Bluescreen-CO/Projet-PPS-2/README.md

# Projet-PPS-2
Projet PPS 2 - Capteur de Gaz
