Bluescreen-CO/Projet-PPS-2/Diagramme Fonctionel/Diagramme_Schématique_VersionFinale.png

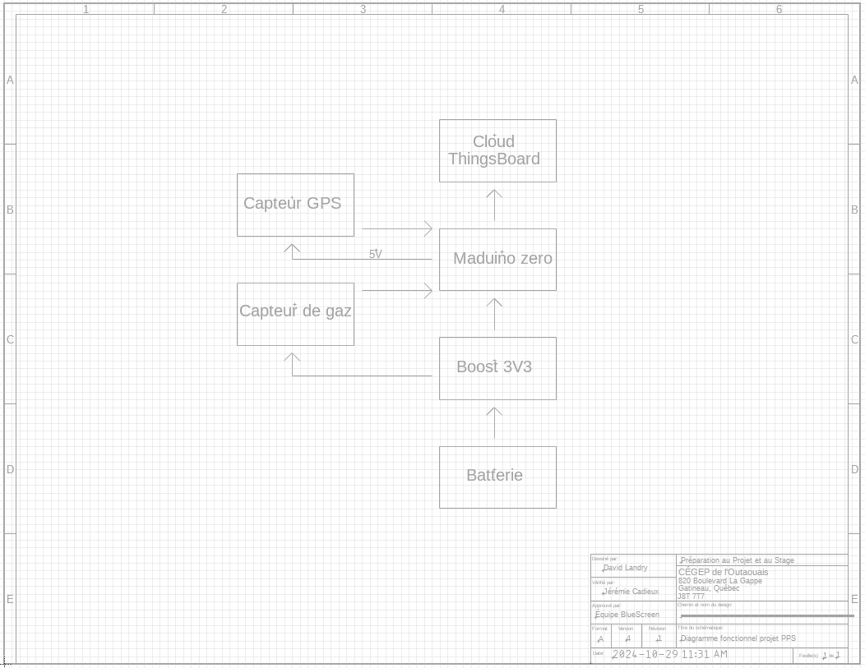
Diagramme Fonctionel/Diagramme_Schématique_VersionFinale.png
