Bluescreen-CO/Projet-PPS-2/Diagramme_Gants/Echeancier3.png

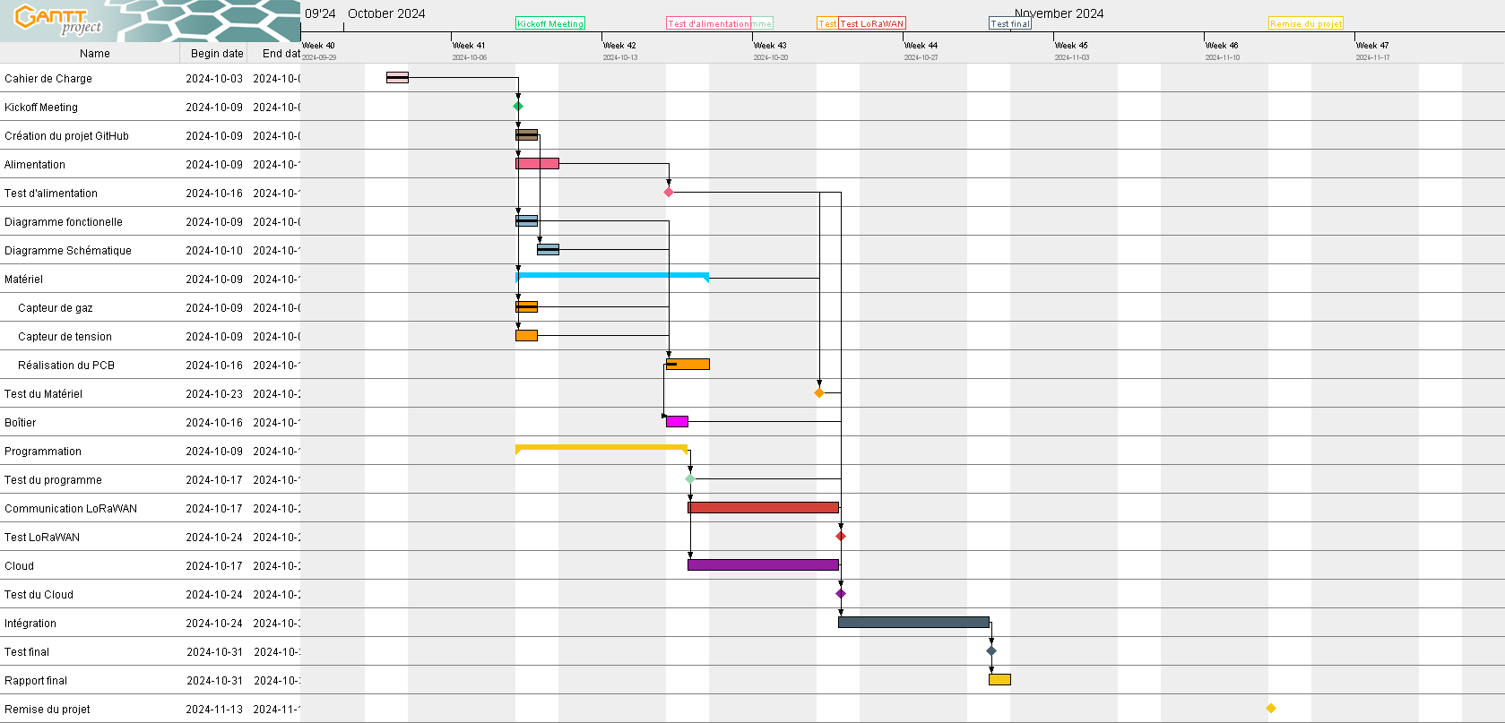
Diagramme_Gants/Echeancier3.png
