Bluescreen-CO/Projet-PPS-2/Diagramme_Gants/Plannification_1.png

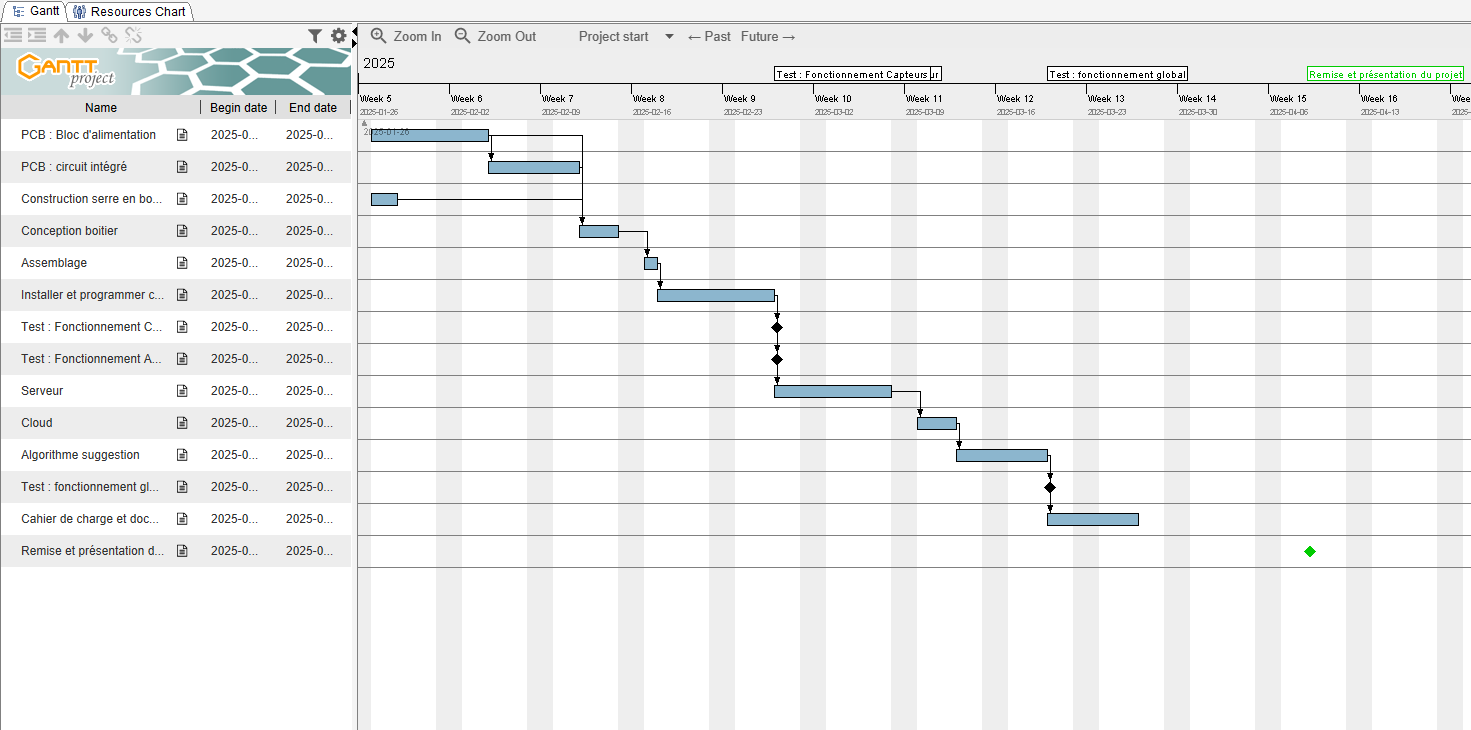
Diagramme_Gants/Plannification_1.png
