Bluescreen-CO/Projet-PPS-2/ProjetPPS_VSCODE_V1/PPS_Equipe_BlueScreen/Photo_Fonctionement/GPS_ArduinoUNO.png

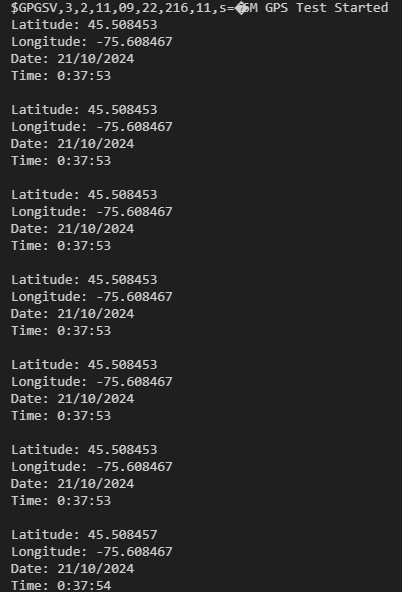
ProjetPPS_VSCODE_V1/PPS_Equipe_BlueScreen/Photo_Fonctionement/GPS_ArduinoUNO.png
