Bluescreen-CO/Projet-PPS-2/Modele_3D/Boitier_3D_Top_v4.stl

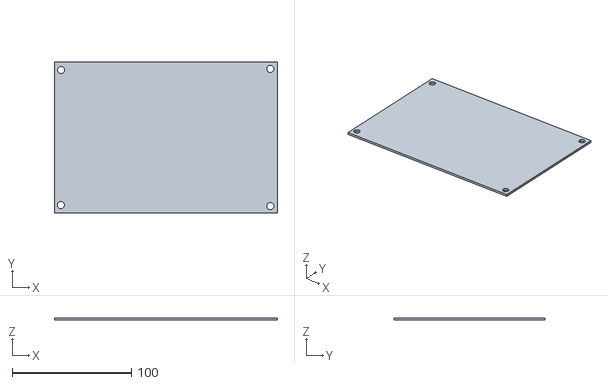
[picture p45: CAD file, 2024-11-06]
Modele_3D/Boitier_3D_Top_v4.stl
187.0 x 127.0 x 2.00
