Bluescreen-CO/Projet-PPS-2/Modele_3D/Modele_3D_v2/boitier3D_top_v8.stl

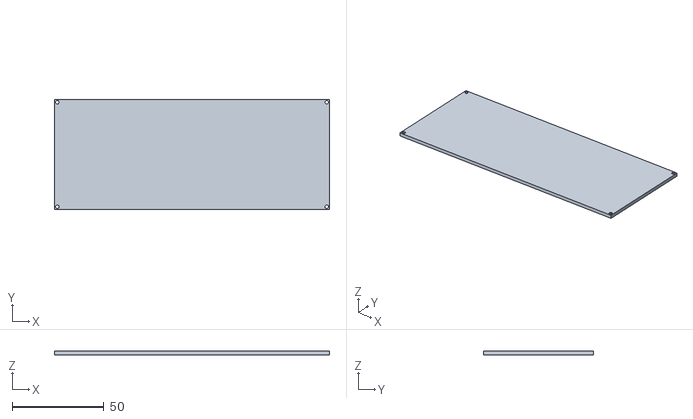
[picture p46: CAD file, 2024-11-14]
Modele_3D/Modele_3D_v2/boitier3D_top_v8.stl
150.0 x 60.0 x 2.00
