Bluescreen-CO/Projet-PPS-2/(list of files, cad)

Other CAD files:
Diagramme Schématique et Matriciel pour la carte principale/Diagramme Matriciel.f3z
Diagramme Schématique et Matriciel pour la carte principale/Diagramme Schématique.f3z
Diagramme Schématique et Matriciel Boost 5V/Diagramme Schématique Boost 5V.f3z
Diagramme Schématique et Matriciel Boost 5V/Schématique Matriciel Boost 5V.f3z
