Bluescreen-CO/Projet-PPS-2/Tableau_problemes_solutions/Liste des problèmes, solutions et choix.xlsx

Sheet: Feuille 1
Dans cette colomne préciser le nom de votre équipe | Dans cette colomne préciser le titre de votre projet PPSx | Dans cette colomne compléter les Prénoms, Noms de l'équipe |  |  | Dans cette colomne décrire au moins 3 problèmes rencontrés pour chaque composante (matérielle, logicielle, réseau et cloud) | Dans cette colomne décrire les solutions envisagées en vis à vis de chaque problème | Dans cette colomne préciser quelle solution a été choisie | Dans cette colomne préciser pour quelles raisons la solution a été choisie
Projet | Équipe | Membres de l'équipe | Composante | Problème | Description du problème | Solutions | Choix | Argumentation
 |  |  | Matérielle (au sens électronique : PCB, plaque à essai, ...) | 1 |  | 1:
 |  |  |  |  |  | 2:
 |  |  |  |  |  | 3 :
 |  |  |  | 2 |  | 1:
 |  |  |  |  |  | 2:
 |  |  |  | 3 |  | 3:
 |  |  |  | 4 |  | 1:
 |  |  |  |  |  | 2:
 |  |  |  |  |  | 3:
 |  |  | Logicielle (embarqué) | 1 |  | 1:
 |  |  |  |  |  | 2:
 |  |  |  |  |  | 3 :
 |  |  |  | 2 |  | 1:
 |  |  |  |  |  | 2:
 |  |  |  | 3 |  | 1:
 |  |  |  |  |  | 2 :
 |  |  |  |  |  | 3 :
 |  |  | Réseau (WiFi / LoRaWAN) | 1 |  | 1 :
 |  |  |  |  |  | 2 :
 |  |  |  |  |  | 3 :
 |  |  |  | 2 |  | 1 :
 |  |  |  |  |  | 2 :
 |  |  |  | 3 |  | 1 :
 |  |  |  |  |  | 2 :
 |  |  |  |  |  | 3:
 |  |  | Cloud (ThingsBoard) | 1 |  | 1:
 |  |  |  |  |  | 2 :
 |  |  |  |  |  | 3 :
 |  |  |  | 2 |  | 1 :
 |  |  |  |  |  | 2 :
 |  |  |  | 3 |  | 1 :
 |  |  |  |  |  | 2 :
 |  |  |  |  |  | 3 :
 |  |  | Boitier (3D) | 1 |  | 1:
 |  |  |  |  |  | 2 :
 |  |  |  |  |  | 3 :
 |  |  |  | 2 |  | 1 :
 |  |  |  |  |  | 2 :
 |  |  |  | 3 |  | 1 :
 |  |  |  |  |  | 2 :
 |  |  |  |  |  | 3:

Sheet: BlueScreen
Dans cette colomne préciser le titre de votre projet PPSx | Dans cette colomne préciser le nom de votre équipe | Dans cette colomne compléter les Prénoms, Noms de l'équipe |  |  | Dans cette colomne décrire au moins 3 problèmes rencontrés pour chaque composante (matérielle, logicielle, réseau et cloud) | Dans cette colomne décrire les solutions envisagées en vis à vis de chaque problème | Dans cette colomne préciser quelle solution a été choisie | Dans cette colomne préciser pour quelles raisons la solution a été choisie
Projet | Équipe | Membres de l'équipe | Composante | Problème | Description du problème | Solutions | Choix | Argumentation
Projet PPS2 : | Équipe BlueScreen | David Landry, Jérémie Cadieux, Tristan Comtois et Damien Tweedy | Matérielle (au sens électronique : PCB, plaque à essai, ...) | 1 | La première version de notre PCB a été mal conçue et n'avait pas pris en considération que pour les composantes traversantes c'est sur la couche bottom que nous devions souder. Cela a eu comme incidence qu'une fois assemblé, notre Maduino était à l'envers. | 1: Essayer de souder les collecteurs en surface | Choix 2 | Problème 1 : Nous avons choisit de repenser et refaire la matricielle car il y avait beaucoup de problème de conception majeur avec notre première version imprimer de notre PCB. De plus nous en avons profiter pour réduire considérablement la dimension du PCB pour permettre le montage sur un casque de vélo plus réaliste. Problème 2 : Nous avons choisit de faire un seul BOOST de 5V pour alimenté le Maduino avec son entré VBAT car celui-ci à un option intégré de fournir de 3V3 que nous pouvons utilisé pour alimenté notre capteur GPS. Cette options est plus compacte et consomme moins d'énergie électriquement que les choix 1 et 2. Problème 3 : Nous avons choisit de vérifier les soudures et de faire des tests électriques. Nous avons trouvé un problème important. VIN et le GROUND étaient connectés ensemble à l'intérieur du bornier male. Le plastique avait fondu et connecté les deux signaux électriquement. Nous avons dessoudé et resoudé un autre connecteur. Le VOUT est maintenant 2.4V, on suspecte qu'il y a un problème avec la composante tps61023dlr.
 |  |  |  |  |  | 2:Repenser et refaire la matricielle en prenant en considération l'orientation et la couche de soudure.
 |  |  |  |  |  | 3 :
 |  |  |  | 2 | Choix des sources d’alimentation 5V et 3V3, Nous avons changé d’idée à plusieurs reprises lors de la considération des sources d’alimentation 5V et 3V3. | 1:Faire un boost de 5V et utilisé un régulateur de tension 3.3V. Cette solution c’est avéré être mauvaise car elle utilisait des composantes qui consommait trop de courant par rapport à d’autre options possibles. | Choix 3
 |  |  |  |  |  | 2:Utilisé 2 boosts (3,3V et 5V) pour alimenter nos composantes. Nous avons vite rejeté cette option lorsque nous avons consulté en profondeur la datasheet et les schématiques du Maduino Zero pour réaliser qu’en utilisant une alimentation par batterie, le Maduino devait être alimenté par du 5V et à la possibilité intégrée de fournir de 3,3V.
 |  |  |  |  |  | 3: Faire un seul boost de 5V pour alimenter le Maduino via le connecteur VBAT et utilisé l’interrupteur SW1 pour choisir l’alimentation USB ou via la Batterie. On utilise le 3,3V fournis par le Maduino pour alimenter le module GPS et le boost de 5V pour alimenter le capteur de gaz.
 |  |  |  | 3 | Problème avec le Boost 5V, une fois le circuit soudé, il ne fournissait pas 5V en sortie. Nous avons mis 3V en entré avec 30mA et mesuré VOUT et VOUT. VIN = 2.98V et VOUT = 0 | 1: Vérifier les soudures et refaire celle qui sembre être flottante | Choix 2 et 3
 |  |  |  |  |  | 2: Test de continuité en mode résistance avec notre multimètre
 |  |  |  |  |  | 3: Refaire le circuit avec de nouvelles composantes
 |  |  |  | 1 | Problème avec l’utilisation du GPS avec communication UART (RX et TX). | 1: Utiliser les bibliothèques tel que SoftwareSerial ou AltSoftSerial pour réassigné les pins RX et TX | Choix 2
 |  |  | Logicielle (embarqué) |  |  | 2: Utiliser les pin D2 et D3 en l'assignation sercom2 . |  | Problème 1 : Nous avons choisit d'utiliser les pins D2 et D3 pour faire la communications UART RX et TX car nous avons vu plusieurs autre projet en ligne qui utilisait c'est 2 pins avec d'autre capteurs avec le même Maduino. Les librairies du choix 1 n'est pas compatible avec notre microcontroleurs. Le choix 3 requière l'ajoût d'une autre composante qui prend de la place, consomme de l'électricité et nous n'étions pas certain que sa serait fonctionnelle. Nous avons donc décidé de ne pas choisir cette solution. Problème 2 : Nous avons essayé d'utilisé des lingetttes alcoolisé et d'autre librairie, mais nous n'avons pas été capable de capté des données pertinante avec le capteur de gaz.
 |  |  |  |  |  | 3 : Utiliser un convertisseur CP2104 USB à Seriel
 |  |  |  | 2 | Problème avec l'utilisation du capteur de gaz, nous étions limité avec les tests de fonctionalités. Nous recevions des valeurs PPM qui n'était pas possible | 1 : Utilisé le capteur de gaz pour détecté l'alcool et utilisé des serviettes nettoyante alcolisé. | Choix 1 et 3
 |  |  |  |  |  | 2 : Essayer d'autre librairies avec notre capteur de gaz
 |  |  |  |  |  | 3 : Essayer un autre capteur de gaz pour vérifier si le notre avait des défectuosités
 |  |  |  | 3 |  | 1 :
 |  |  |  |  |  | 2: | Choix
 |  |  |  |  |  | 3 :
 |  |  |  | 1 | Difficulté à se familiariser avec LoRaWan et Chirpstack | 1 : Lire des blogs et regarder des videos sur le sujet | Choix 1 et 2
 |  |  | Réseau (WiFi / LoRaWAN) |  |  | 2 : Écouter la démonstration de maxime |  | Problème 1 : Travailler avec ChirpStack et LoRaWAN était accablant au début, car c'était un domaine nouveau pour nous. Nous avons donc commencé par lire et nous informer sur le sujet avant de nous lancer dans cette partie du projet. Problème 2 : Après avoir connecté le Maduino Zero à ChirpStack via LoRaWAN, nous avons réussi à recevoir les données, mais nous n'avons pas réussi à les envoyer vers ThingsBoard.
 |  |  |  |  |  | 3 :
 |  |  |  | 2 | Problème lorsque des informations sont envoyer via Chirpstack | 1 : Relire le tutoriel de Maxime sur LoRaWAn | Choix 1 et 2
 |  |  |  |  |  | 2 : Créer une nouvelle application, avec une nouvelle clé
 |  |  |  | 3 |  | 1 :
 |  |  |  |  |  | 2 : | Choix
 |  |  |  |  |  | 3:
 |  |  |  | 1 | Difficulté à se familiarriser avec ThingsBoard et le Dashboard ( widgets, google map) | 1 : Regarder des tutoriels | Choix 1
 |  |  | Cloud (ThingsBoard) |  |  | 2 : Essayer les differents widgets dans des examples |  | Problème 1 : De manière similaire à ChirpStack et LoRaWAN, nous avons dû nous familiariser avec ThingsBoard et les différents widgets du tableau de bord. Nous avons regardé des tutoriels et, finalement, nous avons réussi à créer un tableau de bord adéquat pour notre projet. Problème 2 : Lors des tests de la capacité de ThingsBoard à recevoir des données, nous pouvions envoyer des valeurs fixes via le terminal Windows, mais nous n'avons pas réussi à recevoir les valeurs de notre capteur de gaz ou du GPS via le Maduino Zero.
 |  |  |  |  |  | 3 :
 |  |  |  | 2 | Difficulté recevoir les informations de Chirpstack sur ThingsBoard | 1 : Lire la documentation que maxime a créer sur tge.info | Choix 1
 |  |  |  |  |  | 2 : Changer la configuration de Chirpstack et ThingsBoard
 |  |  |  | 3 |  | 1 :
 |  |  |  |  |  | 2 : | Choix
 |  |  |  |  |  | 3 :
 |  |  |  | 1 | Problème avec les dimensions de la première version du boîtier, les murs étaient trop épaisses et celui-ci était trop gros pour porter sur un casque. | 1: Refaire le boîtier au complet pour que celui-ci respecte les normes d'épaisseur, de compactibilité et de grandeur. | Choix 1 et 2
 |  |  | Boitier (3D) |  |  | 2 : Raptisser les parois du boîtier pour qu'il puisse être plus compact et qu'il puisse s'installer sur un casque de vélo. |  | Problème 1 : Le problème de la première version du boîtier était que les parois étaient trop épaisses, ce qui empêchait son installation adéquate sur un casque de vélo. En refaisant le boîtier, nous avons pu réduire l'épaisseur des parois pour qu'il soit plus compact et qu'il puisse s'installer correctement sur le casque de vélo. Problème 2 : Les dimensions de la deuxième version du boîtier sont encore inexactes. Les parois sont trop minces pour permettre l'insertion des vis nécessaires à la fermeture du boîtier, et la fente n'autorise pas un accès facile au Maduino. En refaisant le boîtier avec des parois un peu plus épaisses et en agrandissant l'ouverture pour faciliter l'accès au Maduino, nous obtiendrons un boîtier conforme à nos exigences. Problème 3 : Les dimensions des trous pour le capteur d'air et l'interrupteur sont trop petites, ce qui empêche leur insertion précise dans le boîtier. En limant les trous, nous avons pu corriger les légères erreurs d'impression en les agrandissant.
 |  |  |  |  |  | 3 : Ajuster les trous et les parois à la lime pour qu'il soit à la bonne épaisseur et grandeur.
 |  |  |  | 2 | Deuxième version : dimension des troues d'attachement pour le couvercle et la fente à l'avant est trop petite pour permettre l'accès du Maduino de l'extérieur | 1 : Refaire le boîtier pour aggrendir les parois pour pouvoir insérer des vis et avoir un accès plus facile du Maduino de l'extérieur.
 |  |  |  |  |  | 2 : Ajuster les trous à la lime pour y insérer les vis et le composant. | Choix 1
 |  |  |  |  |  | 3 : Percer les trous pour y insérer les vis.
 |  |  |  | 3 | Dimension des troues pour le capteur et la switch n'étaient pas parfaitement la bonne dimmension. | 1 : Refaire le boîtier pour aggrendir les trous pour pouvoir insérer le capteur et la switch sans avoir besoin de limer les extrémiter.
 |  |  |  |  |  | 2 : Ajuster les trous à la lime pour y insérer les composants. | Choix 2

Sheet: Feuille 2
Dans cette colomne préciser le nom de votre équipe | Dans cette colomne préciser le titre de votre projet PPSx | Dans cette colomne compléter les Prénoms, Noms de l'équipe |  |  | Dans cette colomne décrire au moins 3 problèmes rencontrés pour chaque composante (matérielle, logicielle, réseau et cloud) | Dans cette colomne décrire les solutions envisagées en vis à vis de chaque problème | Dans cette colomne préciser quelle solution a été choisie | Dans cette colomne préciser pour quelles raisons la solution a été choisie
Projet | Équipe | Membres de l'équipe | Composante | Problème | Description du problème | Solutions | Choix | Argumentation
q | q | Aidan McNulty, Alexandre Nadeau, Nathan-Raphaël Tassé et Xavier Robitaille | Matérielle (au sens électronique : PCB, plaque à essai, ...) | 1 | Notre premier modéle de PCB ne respectait pas vraiment les criteres imposés par le cahier des charges car il était trop gros | 1 :Réduire la taille de notre PCB. | Choix 1 | Problème 1: On avait pas trop le choix que d'opter pour cette solution car il fallait réduire lal taille de notre PCB afin que le boitier ne soit pas trop volumineux pour etre accrocher au plafond.
 |  |  |  |  |  | 2:
 |  |  |  |  |  | 3 :
 |  |  |  | 2 | Au début, notre systeme etait seulement alimenter directement aux batteries, mais lorsque l'alimentation descendait sous les 2.5V environ , le module WiFi ne marchait plus sur notre R-Pi Pico | 1 :Utiliser un module Boost entre nos piles et notre R-Pi Pico afin d'assurer une connexion stable 5V pour l'alimentation | Choix 1
 |  |  |  |  |  | 2 :Augmenter la capacité des batteries
 |  |  |  | 3
 |  |  |  | 4 | Lors de la soudure de notre PCB, le pad de cuivre pour l'alimentation à décoller du PCB donc notre pin d'alimentation n'etait plus connecter avec notre trace d'alimentation | 1 :Connecter nos fils d'alimentations directement sur la trace d'alimentation et sur le plan de masse | Choix 2
 |  |  |  |  |  | 2 :Connecter nos fils d'alimentations direcrement sur les pins headers du module Boost (Vin et GND)
 |  |  |  |  |  | 3 :Refaire un PCB , mais cette fois avec des pads de cuivre plus large pour éviter que le probleme se reproduise
 |  |  | Logicielle (embarqué) | 1 | Nous n'avons pas de partie dans notre code pour dire si le dispositif était allumer ou éteint donc l'utilisateur a aucun moyen de savoir l'etat du Raspberry Pi. | 1: implementer une fonction pour voir l'état du raspberry pi (activé ou désactivé) | Choix 1 | Problème 1: On a opter pour cette solution, car avec une led il faut etre dans la meme piece pour voir s'il est allumer ou pas. Avec une fonction dans le code on peut le voir directement sur le serveur web alors c'est plus efficace. Probleme 2: On a opter pour cette solution, car c'est une option simple a intégrer au code et très efficace. Pendant qu'elle est en mode veille, le raspberry pi consome de micro amperes. Problème 3: On a choisi cette option pour une raison évidente. Cette raison étant que une pile se décharge de maniere exponentielle décroissant donc en ayant une formule linéaire on ne lisait pas correctement le niveau des piles.
 |  |  |  |  |  | 2 : Mettre une led qui est allumer ou eteint avec le raspberry pi.
 |  |  |  |  |  | 3 :
 |  |  |  | 2 | Notre code n'est pas optimisé pour que les piles puissent durées plusieurs mois voir année. | 1 :mettre le Raspberry pi en mode veille quand il envoye pas de donnés | Choix 1
 |  |  |  |  |  | 2 :
 |  |  |  | 3 | Notre calcul du pourcentage pour les piles était linéaire au lieu d'être exponentielle donc le pourcentage vue sur thingsboard n'était pas réellement la vraie tension des piles. | 1 :Faire une fonction exponentielle au lieu de linéaire | Choix 1
 |  |  |  |  |  | 2 :
 |  |  |  |  |  | 3 :
 |  |  | Réseau (WiFi / LoRaWAN) | 1 | Il y a des limitations pour ce qui est de la connexion WiFi car le SSID et le PassWord sont codé en dur donc lorsque qu'on change de WiFi il faut aller changer les informations de connexion manuellement et renvoyer le code de la R-PI Pico. | 1 : Utiliser un mode de configuration par point d'accès | Choix 1 | Problème 1: On a opter pour cette solution, car avec cette méthode il n'y a aucun mot de passe de wifi dans les fichiers, il faut simplement aller sur le site web du raspberry pi et entrer le nouveau SSID et Mot de passe. Problème 2: On a choisi la 2e solution, car en ajoutant un module de gestion de puissance au code, on peut faire en sorte que quand on est vraiment proche du routeur on peut prendre un peut de puissance et quand on est loin on peut en mettre plus.
 |  |  |  |  |  | 2 : Stocker les informations Wi-Fi dans un fichier de configuration
 |  |  |  |  |  | 3 :
 |  |  |  | 2 | Notre module wifi n'est pas réduit dans puissance de transmission donc il envoyait toujours a pleine puissance et consommait beaucoup d'énergie de nos piles. | 1 :Activer le Wi-Fi uniquement quand nécessaire | Choix 2
 |  |  |  |  |  | 2 :Ajouter un module de gestion de puissance externe
 |  |  |  | 3 |  | 1 :
 |  |  |  |  |  | 2 :
 |  |  |  |  |  | 3 :
 |  |  | Cloud (ThingsBoard) | 1 | Le nom des clés d'identifications envoyés depuis le code n'etaient pas les meme que ceux qui etaient ecrit dans le cloud donc les informations sur nos données ne s'affichait pas dans le cloud | 1 :S'assurer que les clés d'identifications envoyer par le code ont les memes noms que ceux qui sont demandés par le cloud | Choix 1 | Problème 1: Nous avons opter pour cette solution, sans
 |  |  |  |  |  | 2 :
 |  |  |  |  |  | 3 :
 |  |  |  | 2 |  | 1 :
 |  |  |  |  |  | 2 :
 |  |  |  | 3 |  | 1 :
 |  |  |  |  |  | 2 :
 |  |  |  |  |  | 3 :
 |  |  | Boitier (3D) | 1 | Au début, on a pas utiliser la bonne methode sur fusion 360 pour faire notre boitier 3D et sa ne respectait pas les bonnes dimensions pour etre imprimer | 1 :Refaire la creation du boitier mais en prenant soin d'utiliser les sketchs et de prendre les bonnes dimensions | Choix 1
 |  |  |  |  |  | 2 :
 |  |  |  |  |  | 3 :
 |  |  |  | 2 | L'ouverture faite sur notre boitier pour permettre le branchement du R-Pi Pico était trop basse | 1 :Refaire le design du boitier, mais cette fois prendre soin de faire l'ouverture pour la connexion plus haute | Choix 2
 |  |  |  |  |  | 2 :Prendre un exacto et couper manuellement une ouverture plus haute pour permettre la connexion au R-PI Pico
 |  |  |  | 3 | On a pas penser a la facon dont les batteries vont pouvoir se connecter au PCB car ils sont tous les deux dans des boitiers différents | 1 :Refaire le design du boitier, mais cette fois mettre l'alimentation et le PCB dans la meme partie et non dans deux partie séparer | Choix 3
 |  |  |  |  |  | 2 :Refaire le design du boitier, mais lors de la creation inclure directement des troues entre les deux parties du boitier afin de faire passer les fils de l'alimentation
 |  |  |  |  |  | 3 :Utiliser une perceuse et faire des troues manuellement entre les deux parties pour faire passer les fils de l'alimentation

Sheet: CAKE
Dans cette colomne préciser le nom de votre équipe | Dans cette colomne préciser le titre de votre projet PPSx | Dans cette colomne compléter les Prénoms, Noms de l'équipe |  |  | Dans cette colomne décrire au moins 3 problèmes rencontrés pour chaque composante (matérielle, logicielle, réseau et cloud) | Dans cette colomne décrire les solutions envisagées en vis à vis de chaque problème | Dans cette colomne préciser quelle solution a été choisie | Dans cette colomne préciser pour quelles raisons la solution a été choisie
Projet | Équipe | Membres de l'équipe | Composante | Problème | Description du problème | Solutions | Choix | Argumentation
Projet PPS3 | CAKE | Kirstan Niamba, Camille Courtemanche, Esther Zoukou, Andyl Omontola Ouabi | Matérielle (au sens électronique : PCB, plaque à essai, ...) | 1 | Notre matricelle a été conceptualisée en surface ce qui rendais la soudure traversante difficile a executer | 1 : Refaire le matrice pour obtenir un PCB alendroit et simple a souder | Choix 2 | Problème 1, 3 et 4: On a décider de ce débrouiller avec le premier PCB pour fournir une carte mère fonctionnable, mais tension du Vbat de la pin du maduino chutais à 0.8~V, alors on a finis par faire le choix 1 qui de refaire le PCB. Problème 2: On a décider de changer la chip, car on pensait qu'il était mal manufacturer après remesurer tous les composant, assurer leur disposition des composants sur le PCB et s'assurer des connextion. Problème 5: On a décider de changer la chip, car c'était un erreur non prévue. Problème 6. On a changer de GPS (NEO 6M GPS) car le notre etaot abimer
 |  |  |  |  |  | 2: Souder des fils pour faire les connection necessaire
 |  |  |  |  |  | 3 : Surélever mes composant pour soudre en dessus
 |  |  |  | 2 | Notre booster a court-circuité, après avoir mis une charge de 100mA. On a réaliser que le court-circuit se fesait appartir du chip TPS61023DRLR https://1drv.ms/i/c/0c71c9dd0a9933b8/Edi6JOcQmj9MuVJKOHjLDsIBkXXxFT3EGUuqhkjsY-7Wew?e=Uqea75 | 1: Changer la chip | Choix 1
 |  |  |  |  |  | 2: Soudre une autre PBC (Booster)
 |  |  |  |  |  | 3: Couper entre les traces
 |  |  |  | 3 | Notre GPS a été mis vers l'extérieur de pcb, alors qu'elle devrait être tourner vers l'intérieure | 1: Refaire mon matriciel pour avoir un nouveaux PCB | Choix 2
 |  |  |  |  |  | 2: Couper les traces et soudre des fils
 |  |  |  | 4 | Les troues des beigneit dédié à notre booster étais trops petite pour insérer le connecteur à trois pin. | 1 : Refaire le PCB pour échanger les taces pour une avec de plus gros troue | Choix 2
 |  |  |  |  |  | 2: Élargir à main les troues
 |  |  |  |  |  | 3: Fixer avec des fils et soudure
 |  |  |  | 5 | On a court-circuité la chip TPS61023DRLR en mesurant la tension à sa rentré, alors qu'on voulait dépanner pour trouver pour la raison que la tension de sortie ne donnait pas 5V | 1: Changer la chip avec plus d'attention | Choix 1
 |  |  |  | 6 | Le GPS (NEO-6M GPS) ne communique pas avec le Maduino. | 1. Changer de GPS (NEO 6M GPS) | Choix 1
 |  |  |  |  |  | 2. Faire plus de recherche
 |  |  |  |  |  | 3.
 |  |  | Logicielle (embarqué) | 1 | Le GPS et Lorawan utilises les modules Rx et Tx pour fonctionner, pourtant il n'y a qu'un seul Rx et Tx sur le Maduino. | 1: Modifier des pins pour rendre la communication série possible sur celles-ci | Choix 1: Modifier des pins pour rendre la communication série possible sur celles-ci | Problème 1: On a opter pour cette solution, car c'était la seule facon qu'on a pu trouver pour pourvoir utiliser Lorawan et le GPS en même temps. Probleme 2: On a opter pour cette solution, car c'est une option plus simple que l'autre puisqu'elle facilitera la suite sur chirpstack et sur Thingsboard. Problème 3: Nous avons choisi cette option, car si ne trouvons pas une facon d'envoyer la valeur en négatif, l'affichage de la position ne sera jamais correct.
 |  |  |  |  |  | 2 :
 |  |  |  |  |  | 3 :
 |  |  |  | 2 | Pour le codec Cayenne LPP, il y avait toute sorte de gestion de capteurs déjà intégré, sauf notre capteur de concentration d'oxygène. Donc dans l'envoie des données je ne savais pas je devais envoyer cette donnée sous quel type. | 1 : Créer un autre codec a utiliser pour notre capteur de concentration d'oxygène. | Choix 2 : Envoyer les données digitales puis receuillir cette donnée sur Thingsboard et les formater pour afficher en mg/L.
 |  |  |  |  |  | 2 : Envoyer les données digitales puis receuillir cette donnée sur Thingsboard et les formater pour afficher en mg/L.
 |  |  |  | 3 | Les coordonnées du GPS sont envoyée via Lorawan, on peut les voir sur Chirpstack et sur le moniteur série d'Arduino, pourtant les données recu sur Thingsboard, plus précisément celle sur la longitude, ne sont pas les même que celles envoyées. L'envoie des données est donc mal fait. L'hypothèse est que la valeur négative de la longitude n'est pas prise en compte lors de la conversion en hexadécimal, ce qui empeche l'envoit correct des données. | 1: Effectuer une conversion en hexadécimale qui prend en compte les valeurs négative | Choix 1: Effectuer une conversion en hexadécimale qui prend en compte les valeurs négative
 |  |  |  |  |  | 2 :
 |  |  |  |  |  | 3 :
 |  |  | Réseau (WiFi / LoRaWAN) | 1 | Gérer la communication entre le Maduino, ChirpStack et Thingsboard. | 1 : Regarder des forumes/videos informatif | Choix 2 | 1: Nous avons choisi de suivre une formation, car nous ne possédons pas les connaissances sur ce type de communication réseau. 2: Le suivi du guide officiel de Semtech nous a aidés à comprendre le fonctionnement du backend. 3: Le suivi du guide officiel de Semtech nous a aidés à comprendre le fonctionnement du backend.
 |  |  |  |  |  | 2 : Obtenir une fromation sur les platformes ChirpStack et Thingsboard
 |  |  |  |  |  | 3 : Suivre le guide officiel de LoRaWAN
 |  |  |  | 2 | Comprendre le côté backend du réseau LoRaWAN. | 1 : Suivre un guide GitHub | Choix 2
 |  |  |  |  |  | 2 : Regarder des forumes/videos informatif.
 |  |  |  | 3 | La création d'une application sur ChirpStack pour le Maduino. | 1 : Suivre le guide officiel de LoRaWAN | Choix 1
 |  |  |  |  |  | 2 : Demander de l'aide
 |  |  |  |  |  | 3 :
 |  |  | Cloud (ThingsBoard) | 1 | Le acess token (clé d'identification) crées depuis le Thingsboard ne correspondaient pas à celles à enregistrées pour ChripStack, ce qui empêchait l'affichage des informations sur nos données dans les télémétries de Thingsboard . | 1 :S'assurer que le acess token (clés d'identification) crées par Thingboardssoit le même nom que pour ChripStack | Choix 1 | 1: Nous avons choisi le premier choix, car il existe une panoplie d'informations sur la configuration d'un appareil sur ThingsBoard. 2. Il existe une panoplie d'informations sur le placement des widgets. 3. Il existe une panoplie d'informations sur le placement des widgets.
 |  |  |  |  |  | 2 :
 |  |  |  |  |  | 3 :
 |  |  |  | 2 | Les données envoyées par le Maduino n'étaient pas les mêmes que celles initialement placées dans le tableau de bord pour les widgets. | 1 : Regarder des forumes/videos informatif. | Choix 1
 |  |  |  |  |  | 2 : Demander pour des pistes
 |  |  |  | 3 | Nous n'arrivions pas à bien choisir les widgets sur notre tableau de bord. | 1 : Regarder des forumes/videos informatif. | Choix 1
 |  |  |  |  |  | 2 : Demander pour des pistes
 |  |  |  |  |  | 3 :
 |  |  | Boitier (3D) | 1 | Le trou fait dans le boitier pour pouvoir accéder au bouton de reset sur le maduino n'est pas assez gros pour qu'un doigt puisse atteindre le bouton. | 1 : Limer le trou pour l'aggrandir. | Choix: Limer le trou pour l'aggrandir. | 1 : Cette solution a été choisie parce qu'elle était la plus simple et la plus efficace. 2: Cette solution a été choisie car, séparer les éléments fusionnés aurait pris plus de temps que simplement reboucher le trou, puisque j'étais déjà beaucoup avancée. 3: Cette solution a été choisie car, élargir les trou offrait un résultat garanti et rapide, tandis que l'autre solution non puisque rien ne garanti que je trouverais un autre interrupteur adéquat.
 |  |  |  |  |  | 2 : Reconceptualiser le boitier pour aggrandir le troue
 |  |  |  |  |  | 3 : Laisser cacher le bouton reset
 |  |  |  | 2 | Un trou avait déjà été fait sur une des facade du boitier pour permettre un accès au port USB. Cependant le trou avait été fait à une hauteur qui le tenait pas en compte la hauteur des pinheads sur lesquels sera posé le Maduino donc, le trou était à la mauvaise hauteur. On s'est rendu compte de cette erreur après avoir fusionneé plusieurs autres parties du boitier ensemble. | 1 : Séparer les élements fusionnés du boitier pour pouvoir déplacer le bloc qui créait le trou | Choix 2 : Reboucher le trou et en faire un autre au bon endroit
 |  |  |  |  |  | 2 : Reboucher le trou et en faire un autre au bon endroit
 |  |  |  | 3 | Les trous créés pour pouvoir visser l'interrupteur au boitier n'était pas placer exactement au bon endroit. Lorsque l'interrupteur est placé, les trous sur le boitier ne sont pas vis à vis les trous de l'interrupteur. | 1 : Changer d'interrupteur | Choix 2 : Élargir les trous du boitier avec une vis, pour ainsi créer un espace vis à vis les trous de l'interrupteur.
 |  |  |  |  |  | 2: Élargir les trous du boitier avec une vis, pour ainsi créer un espace vis à vis les trous de l'interrupteur. 3. Refaire le boitier au complet
